JJFrisch/SpiRobControls/Assets/Digital Pins Connections.jpg

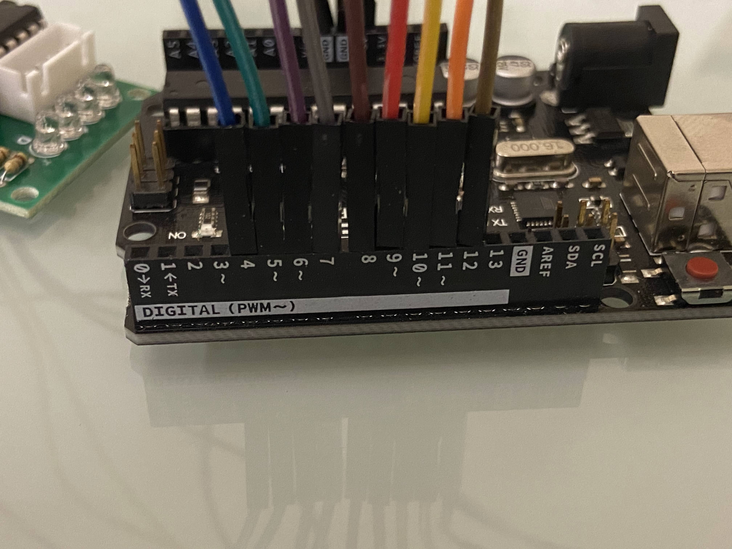
Assets/Digital Pins Connections.jpg
