JJFrisch/SpiRobControls/Assets/Full Arduino Circiut.jpg

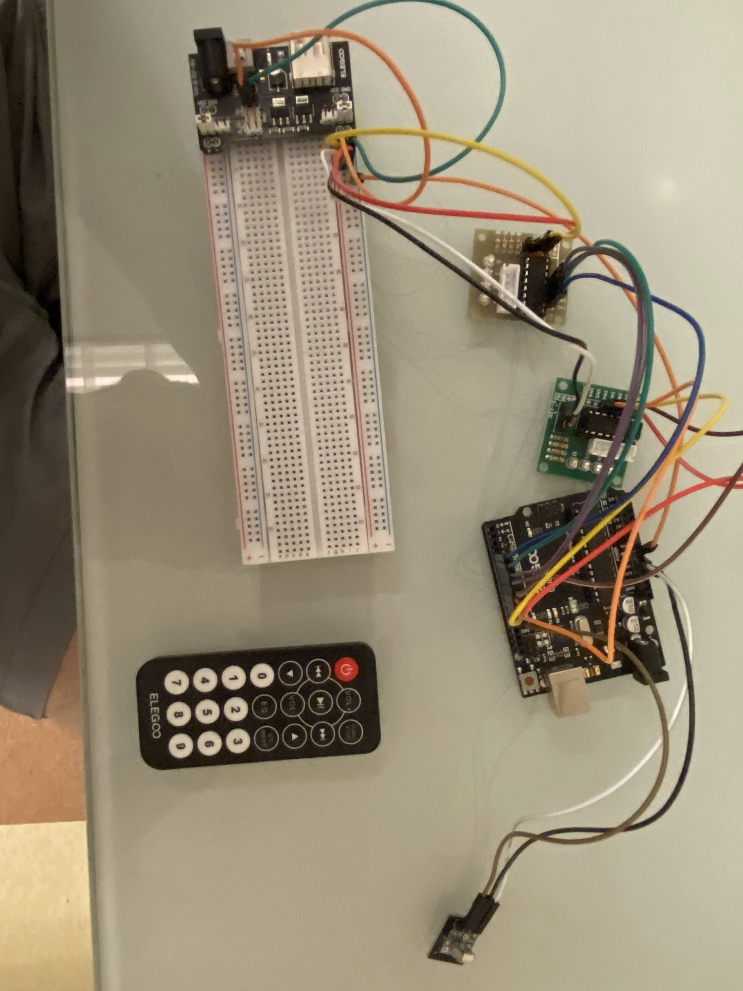
Assets/Full Arduino Circiut.jpg
