JJFrisch/SpiRobControls/Assets/Top-Down View of SetUp.jpg

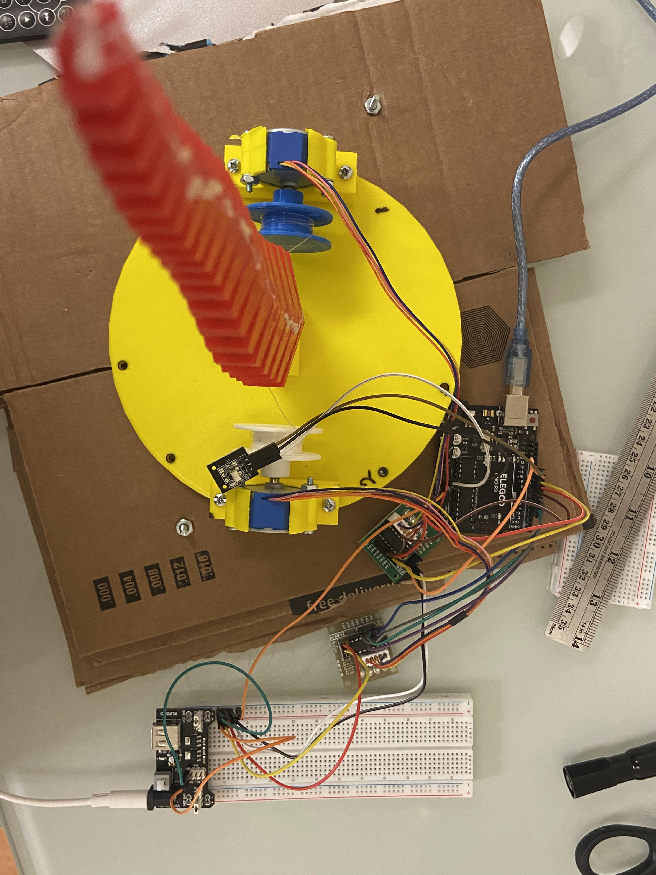
Assets/Top-Down View of SetUp.jpg
