JJFrisch/SpiRobControls/Assets/Weighted_Base.jpg

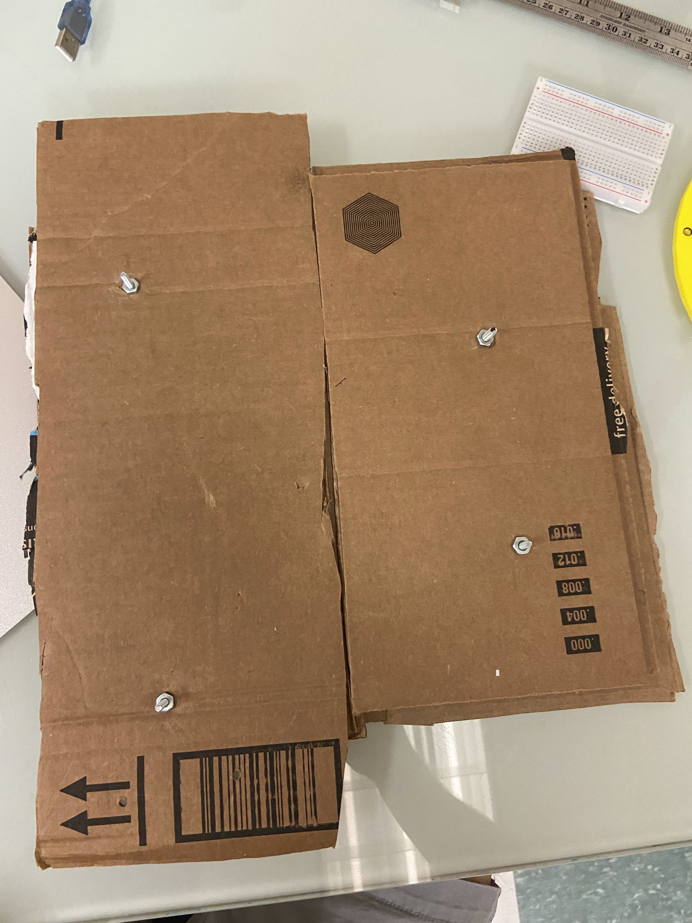
Assets/Weighted_Base.jpg
