JJFrisch/SpiRobControls/Data SpiRobs/SpiRob Assembly.SLDASM

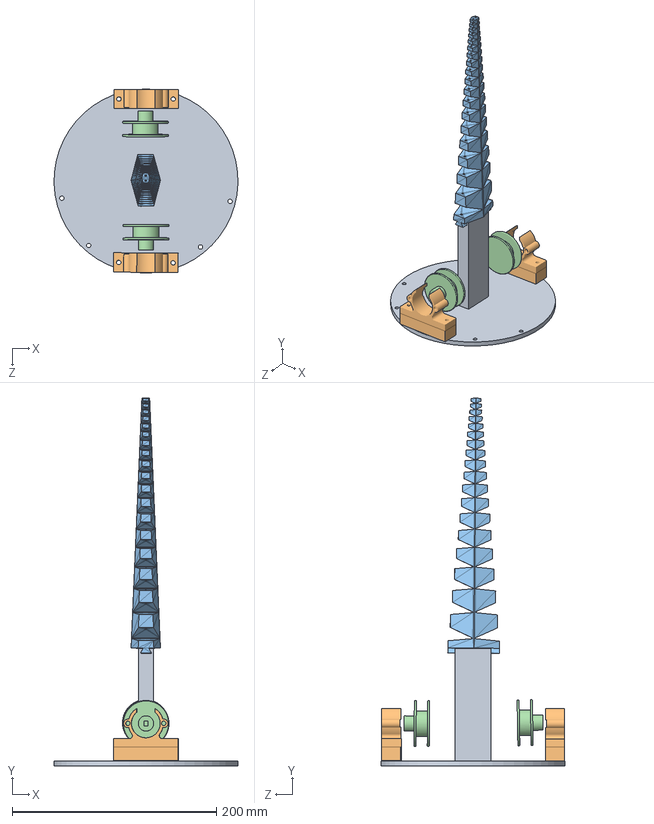
[picture p6: CAD file, 2025-06-02]
Data SpiRobs/SpiRob Assembly.SLDASM
179.9 x 360.0 x 180.0 mm
Base For SpiRob (5-22-25)
28byj-48-holder_longer base x 2
2-cable SpiRob
28byj-48_Spool_v1 x 2
