JJFrisch/SpiRobControls/Models/28byj-48_Spool_v1.SLDPRT

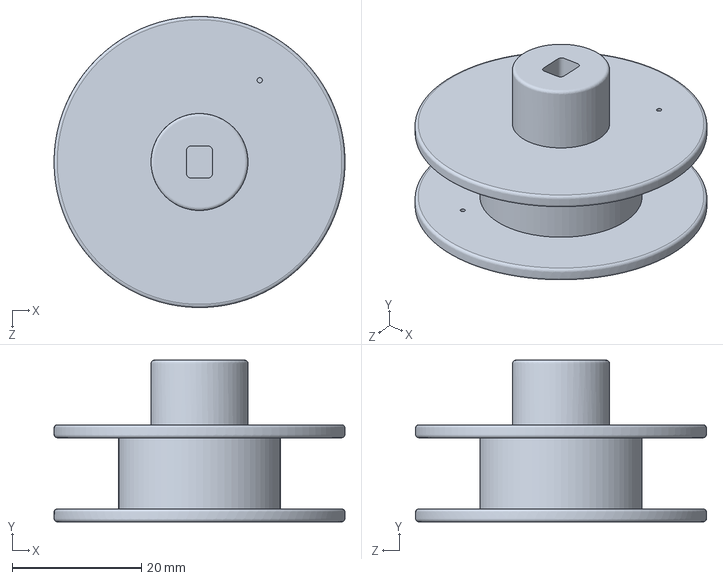
[picture p7: CAD file, 2025-06-02]
Models/28byj-48_Spool_v1.SLDPRT
45.0 x 25.0 x 45.0 mm
