JJFrisch/SpiRobControls/spirob_assets/left_motor_mount.STL

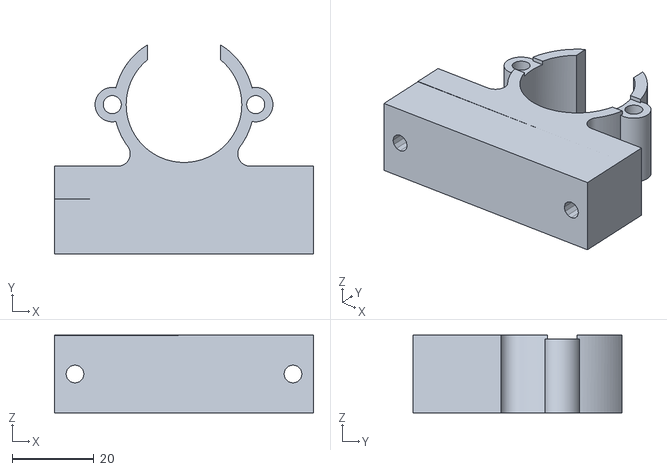
[picture p8: CAD file, 2025-05-22]
spirob_assets/left_motor_mount.STL
63.2 x 51.1 x 19.0
