JJFrisch/SpiRobControls/spirob_simulation/spirob_assets/base_frame.STL

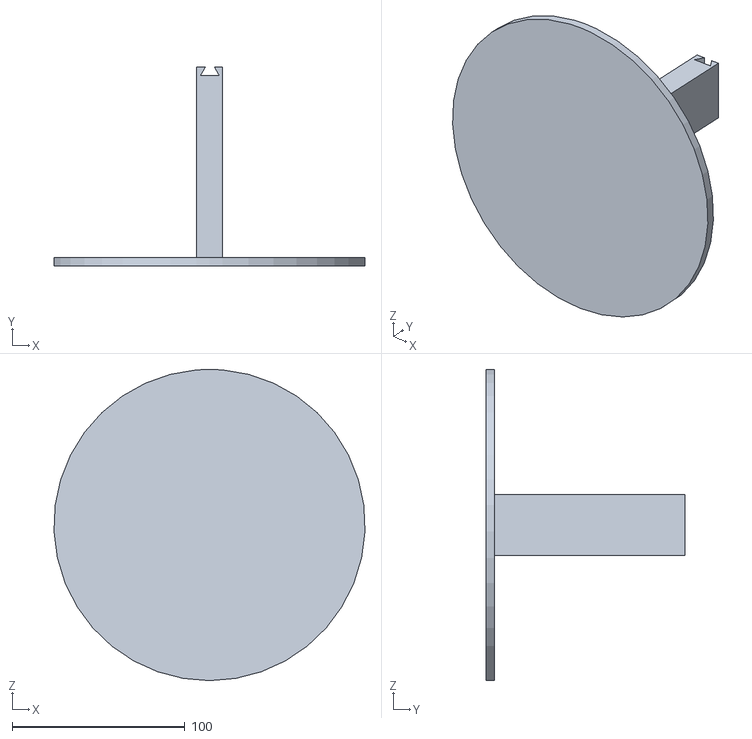
[picture p9: CAD file, 2025-06-06]
spirob_simulation/spirob_assets/base_frame.STL
179.8 x 115.0 x 180.0
