JJFrisch/SpiRobControls/Data SpiRobs/2-cable SpiRob.SLDPRT

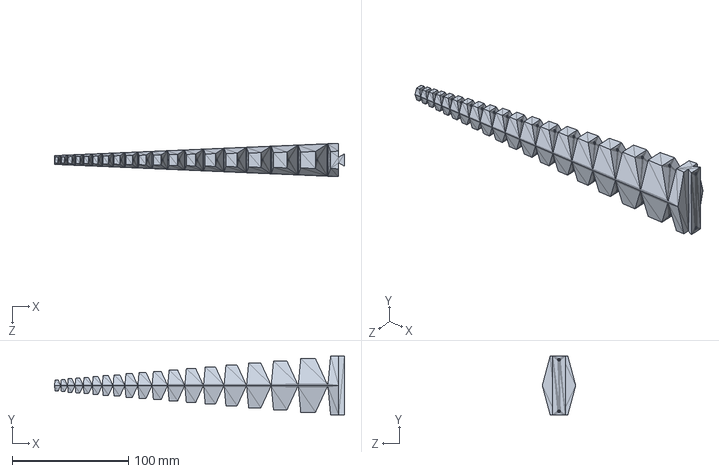
[picture p10: CAD file, 2025-05-22]
Data SpiRobs/2-cable SpiRob.SLDPRT
249.7 x 50.6 x 28.8 mm
