JJFrisch/SpiRobControls/spirob_simulation/spirob_assets/left_spool.STL

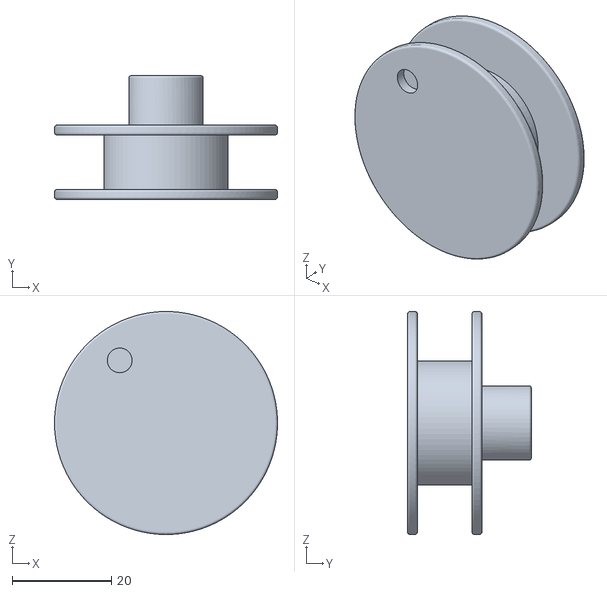
[picture p11: CAD file, 2025-06-06]
spirob_simulation/spirob_assets/left_spool.STL
45.0 x 25.0 x 45.0
