JJFrisch/SpiRobControls/Models/BasePart2.SLDPRT

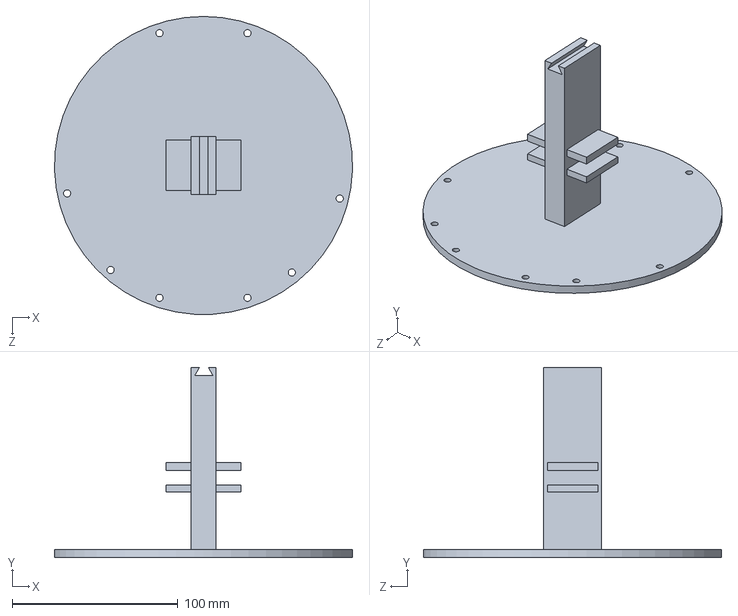
[picture p12: CAD file, 2025-05-16]
Models/BasePart2.SLDPRT
179.9 x 115.0 x 180.0 mm
