JJFrisch/SpiRobControls/(list of files, cad)

Other CAD files:
Models/Base For SpiRob (5-22-25).SLDPRT
Models/Spool with holes (28byj-48) (5-22-25).STL
Models/Spool with holes (28byj-48) (5-21-25).STL
Models/28byj-48-holder_longer base.SLDPRT
Models/BasePart_ArduinoHolders.SLDPRT
Models/BasePart.SLDPRT
Models/Base With Arduino Holders.STL
Models/05202025_BASEUPDATED.SLDPRT
Models/05202025_BASEUPDATED.STL
Models/BasePart.STL
Models/Data SpiRobs/2-cable SpiRob.STL
