JJFrisch/SpiRobControls/.thumbs/256x256/Extension_Test.usd.png

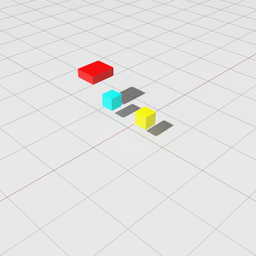
.thumbs/256x256/Extension_Test.usd.png
