JJFrisch/SpiRobControls/Controls/bipolar_stepper_motor/bipolar_stepper_motor.ino

/**
 * bipolar_stepper_motor.ino
 *
 * Controls a bipolar stepper motor driver (e.g. L298N) using two push buttons.
 * Pressing Button 1 drives the motor forward; Button 2 drives it backward.
 *
 * Wiring:
 *   Driver forward pin  -> Arduino pin 8
 *   Driver backward pin -> Arduino pin 12
 *   Button 1 (forward)  -> Arduino pin 2  (INPUT_PULLUP, active LOW)
 *   Button 2 (backward) -> Arduino pin 3  (INPUT_PULLUP, active LOW)
 *
 * Hardware: Arduino Uno + L298N (or equivalent) bipolar stepper driver
 */

const int forwardPin = 8;
const int backwardPin = 12;
const int delayTime = 2000;
const int but1pin = 2;
const int but2pin = 3;
int but1;
int but2;


void stopSpin(){
  digitalWrite(forwardPin, LOW);
  digitalWrite(backwardPin, LOW);
  delay(delayTime);
}

void forward(){
  digitalWrite(forwardPin, HIGH);
  digitalWrite(backwardPin, LOW);
  delay(delayTime);
}

void backward(){
  digitalWrite(forwardPin, LOW);
  digitalWrite(backwardPin, HIGH);
  delay(delayTime);
}

void setup() {
  // put your setup code here, to run once:
  pinMode(forwardPin,OUTPUT);
  pinMode(backwardPin,OUTPUT);
  pinMode(but1pin,INPUT_PULLUP);
  pinMode(but2pin,INPUT_PULLUP);
}

void loop() {
  // put your main code here, to run repeatedly:

  but1 = digitalRead(but1pin);
  but2 = digitalRead(but2pin);

  if (but1 == HIGH){
    digitalWrite(forwardPin, LOW);
  }else{
    digitalWrite(forwardPin, HIGH);
  }

  if (but2 == HIGH){
    digitalWrite(backwardPin, LOW);
  }else{
    digitalWrite(backwardPin, HIGH);
  }
  
  
//  stopSpin();
//  forward();
//  stopSpin();
//  backward();
  
}
