JJFrisch/SpiRobControls/(commit log)

2025-05-08 Added Buttons to Control Bipolar Motor
    Buttons control which direction the motor goes or if it stops.
2025-05-16 Adding Models and Code
    Spool model
    Motor Holder Model
    Base Model
    Base with arduino holders model
    IR remote control - length and steps with max limits and return to 0
    IR untested control over 3 motors with above characteristics
2025-05-21 Added MuJoCo and IssacGym Preliminary Code
    To simulate the 3-cable SpiRob I am using MuJoCo. Afterwards I will use reinforcement learning through Issac Gym.
2025-05-22 Building a SpiRob assembly in SolidWorks
2025-06-02 Multi-Motor Control
    In thus update I am working on controlling both motors with the remote.
2025-06-06 Adding two of the testing files
    Finding the max steps and testing the relax ratio of the passive motor.
2026-04-08 Add bipolar stepper motor control and remove multi-motor control
    - Implemented a new Arduino sketch for controlling a bipolar stepper motor using two buttons for forward and backward movement.
    - Deleted the existing multi-motor control sketch that utilized the AccelStepper and MultiStepper libraries.
    - Added a comprehensive setup guide for the Isaac Lab environment tailored for the SpiRob project, including system requirements, installation steps, project structure, asset preparation, environment configuration, and training scripts.
    - Created a MuJoCo implementation for the SpiRob project, including model definitions, environment setup, and configuration files.
2026-04-08 Fix typos and improve clarity in testing documentation; update README for models and print settings
